mindyh/BitBot/Notes/bumper_top.png

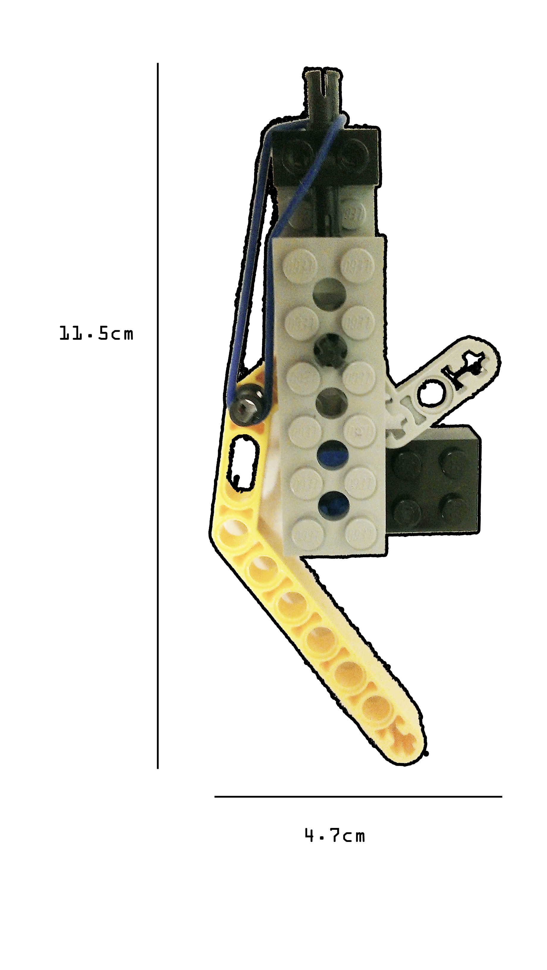
Notes/bumper_top.png
