mindyh/BitBot/README.md

BitBot
======

ME210 Project. Mindy Huang, Josh Grinberg, Pedro Milani, Chris Ling.
