mindyh/BitBot/Notes/bumper_side.png

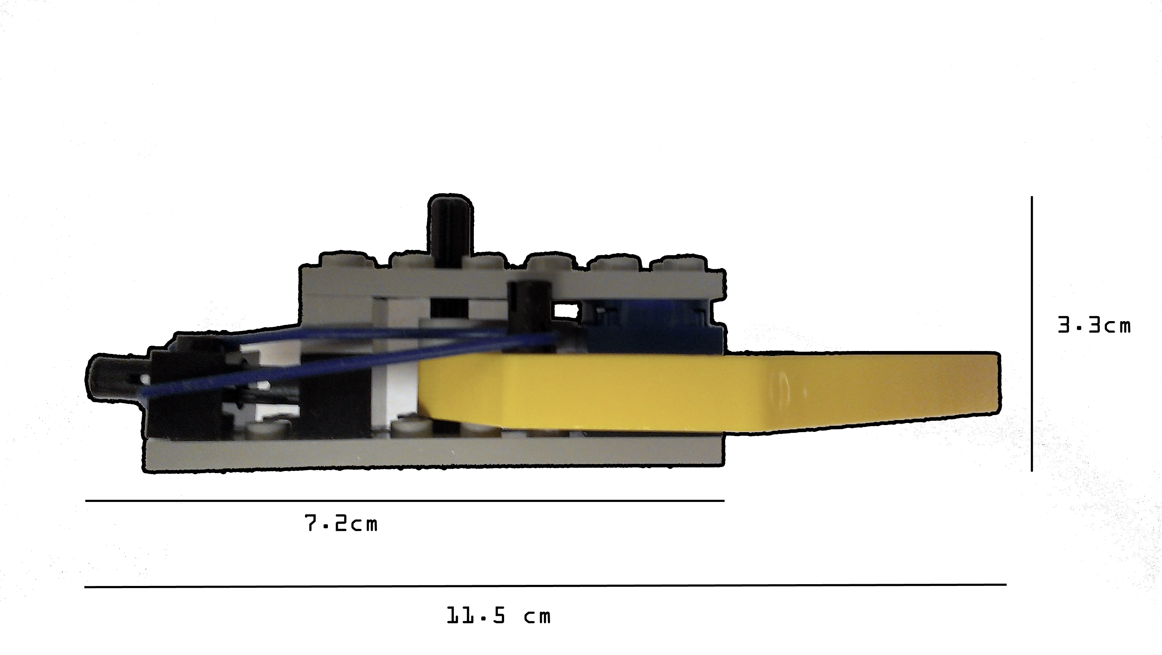
Notes/bumper_side.png
