mindyh/BitBot/Test/Beacon/beacon test results.txt

at no signal - ~511.
at 3k - b/t 470 and 530

160 - 770

w/o blinders, read signals up to 45 deg skewed
w/ my fingers as blinders, read signals up to ~10 deg skwed

need to do distance testing!!!
