mindyh/BitBot/BotCoin.ino

/*
* BotCoin.ino
* ---------------
* Mindy Huang
*/

#include <Timers.h>
#include "BotCoin.h"
#include <Drivetrain.h>
#include <Bumpers.h>
#include <Beacon.h>
#include <LineSensors.h>
#include <Turntable.h>
#include <ButtonPresser.h>
#include <Servo.h>

/*----- Module Variables ----*/
static Direction currentDirection;

Servo myservo;
Bumpers bumpers(BUMPER_FL_PIN, BUMPER_BL_PIN, BUMPER_FR_PIN, BUMPER_BR_PIN);
Beacon serverBeacon(BEACON_SERVER_PIN, BEACON_THRESHOLD_VAL);
Beacon exchangeBeacon(BEACON_EXCHANGE_PIN, BEACON_THRESHOLD_VAL);
Beacon sideServerBeacon(SIDE_SERVER_PIN, BEACON_THRESHOLD_VAL);
Beacon sideExchangeBeacon(SIDE_EXCHANGE_PIN, 250);
LineSensors lineSensors(LIGHT_PIN_CENTER, LIGHT_PIN_FRONT, LIGHT_THRESHOLD_VAL);
Drivetrain drivetrain(MOTOR_1_DIR_PIN, MOTOR_2_DIR_PIN, MOTOR_1_ENABLE_PIN, MOTOR_2_ENABLE_PIN);
Turntable turntable(TURNTABLE_ENABLE_PIN, TURNTABLE_DIR_PIN);
ButtonPresser presser(BUTTON_PRESSER_PIN, myservo);

Direction switchSpinDir = SPIN_LEFT;
static unsigned long time = 0;
static boolean isSeekingLine = false;
static SideOfServer startingSideOfServer;
static SideOfServer currSideOfServer;
static int numRuns = 0;
static TargetExchange targetExchange = targetOrder[numRuns];
static int targetPresses[] = {15, 45, 105};
static float targetCoins[] = {5.0, 3.0, 8.0};

    
/*---- Main Program ---*/
void setup()
{
    // initialize serial communication at 9600 bits per second:
    Serial.begin(9600);

    // init variables
    pinMode(HEARTBEAT_LED, OUTPUT);
    myservo.attach(BUTTON_PRESSER_PIN);
    digitalWrite(HEARTBEAT_LED, HIGH);
    serverBeacon.Clear();
    exchangeBeacon.Clear();
    sideExchangeBeacon.Clear();
    sideServerBeacon.Clear();
    drivetrain.Stop();
    presser.Press();

    // Start timers
    TMRArd_InitTimer(HEARTBEAT_TIMER, ONE_SEC / 2);   // to know we're alive
    TMRArd_InitTimer(CLEAR_BEACON_TIMER, BEACON_CLEAR_PERIOD); // we have 20Hz sampling rate on beacons
    // Bot to shut off automatically in 2 minutes
    TMRArd_InitTimer(ENDGAME_TIMER, 120 * ONE_SEC);  

    // clear timers to make sure they don't start expired
    TMRArd_ClearTimerExpired(BUTTON_PRESS_TIMER);
    TMRArd_ClearTimerExpired(BRAKING_TIMER);
    TMRArd_ClearTimerExpired(ALIGNING_TIMER);
    TMRArd_ClearTimerExpired(TRAVELLING_TIMER);
    TMRArd_ClearTimerExpired(SEEKING_TIMER);
}

void loop()
{
    static State currState = WAITING_TO_START;
    static State returnToState;
    static boolean isFirstRun = true;
    static int numCoinsMined = 0;
    static unsigned long startTime;
    static int numResetEndTimer = 0;
   // static int targetCoins;

    // Always do
    if (TMRArd_IsTimerExpired(HEARTBEAT_TIMER))
    {
        TMRArd_InitTimer(HEARTBEAT_TIMER, ONE_SEC);
        digitalWrite(HEARTBEAT_LED, !digitalRead(HEARTBEAT_LED));
    }

    exchangeBeacon.Update();
    serverBeacon.Update();
    sideExchangeBeacon.Update();
    sideServerBeacon.Update();

    if (TMRArd_IsTimerExpired(CLEAR_BEACON_TIMER))
    {
        serverBeacon.Clear();
        exchangeBeacon.Clear();
        sideServerBeacon.Clear();
        sideExchangeBeacon.Clear();
        TMRArd_InitTimer(CLEAR_BEACON_TIMER, BEACON_CLEAR_PERIOD);
    }
    
    if (TMRArd_IsTimerExpired(ENDGAME_TIMER))
    {
        if(numResetEndTimer == 3) {
          currState = WAITING_TO_END;
          turntable.Stop();
          drivetrain.Stop();
          presser.Rest();
        } else {
          TMRArd_InitTimer(ENDGAME_TIMER, (unsigned long)(30 * ONE_SEC));   
          numResetEndTimer++;
        }
    }

    // State dependent
    switch (currState)
    {
    case WAITING_TO_START:
        // kick to start
        if (bumpers.IsFrontPressed())
        {
            currState = SEEKING_SERVER;
            Transition(SEEKING_SERVER);
            // Bot to shut off automatically in 2 minutes
            TMRArd_InitTimer(ENDGAME_TIMER, (unsigned long)(30 * ONE_SEC));   
        }
        break;
    case SEEKING_SERVER:
        // found line, align with beacon
        if (lineSensors.IsCenterOverLine())
        {
            TMRArd_StopTimer(SEEKING_TIMER);
            TMRArd_ClearTimerExpired(SEEKING_TIMER);

            int deltaT = millis() - time;
            if (deltaT > DYNAMIC_BRAKE_TIME)
            {
                currState = BRAKING;
                returnToState = ALIGNING_WITH_SERVER;
                Brake(GetBrakeDir(), deltaT);
            }
            else
            {
                currState = ALIGNING_WITH_SERVER;
                Transition(ALIGNING_WITH_SERVER);
            }
        }
        // found the beacon, now spin left or right
        else if (serverBeacon.IsFacingBeacon()) 
        {
            // clear timer
            TMRArd_StopTimer(SEEKING_TIMER);
            TMRArd_ClearTimerExpired(SEEKING_TIMER);
            presser.Rest();

            // check what side of field you're on 
            if(isFirstRun) {
              isFirstRun = false;
              if(sideExchangeBeacon.IsFacingBeacon())  {
                  startingSideOfServer = RIGHT;
                  currSideOfServer = RIGHT;
                  presser.Press();
              }
              else {
                  startingSideOfServer = LEFT;
                  currSideOfServer = LEFT;
                  presser.Rest();
              }
            }

            // brake if necessary
            int deltaT = millis() - time;
            if (deltaT > DYNAMIC_BRAKE_TIME)
            {
                currState = BRAKING;
                returnToState = (currSideOfServer == LEFT) ? SEEKING_LEFT : SEEKING_RIGHT;
                Brake(GetBrakeDir(), deltaT);
            }
            else
            {
                currState = (currSideOfServer == LEFT) ? SEEKING_LEFT : SEEKING_RIGHT;
                Transition(currState);
            }

        } 
        // stuck in dead zone w/ no beacon signal. 
        // Go towards exchange (guaranteed to be found)
        else if (TMRArd_IsTimerExpired(SEEKING_TIMER))
        {
            TMRArd_ClearTimerExpired(SEEKING_TIMER);

            currState = SEEKING_EXCHANGE_2;
            Transition(SEEKING_EXCHANGE_2);
        }
        break;

    case SEEKING_RIGHT:
        if(TMRArd_IsTimerExpired(SEEKING_TIMER)) {
            TMRArd_ClearTimerExpired(SEEKING_TIMER);
            currState = TRAVELLING_TO_SERVER;
            Transition(TRAVELLING_TO_SERVER);
        }
        break;

    case SEEKING_LEFT:
        if(TMRArd_IsTimerExpired(SEEKING_TIMER)) {
            TMRArd_ClearTimerExpired(SEEKING_TIMER);
            currState = TRAVELLING_TO_SERVER;
            Transition(TRAVELLING_TO_SERVER);
        }
        break;

    case SEEKING_EXCHANGE_2:
        // found exchange, go towards it and resume searching for server
        if(exchangeBeacon.IsFacingBeacon()) 
        {
            TMRArd_StopTimer(SEEKING_TIMER);
            TMRArd_ClearTimerExpired(SEEKING_TIMER);

            currState = BACKING_UP;
            returnToState = SEEKING_SERVER;
            Backup(1.5, BACKWARD);
        }
        // did not find (should never happen), randomly 
        // drive somewhere and try again
        else if (TMRArd_IsTimerExpired(SEEKING_TIMER)) {
            TMRArd_ClearTimerExpired(SEEKING_TIMER);

            currState = TRAVELLING_TO_SERVER;
            Transition(TRAVELLING_TO_SERVER);
        }
        break;

    case TRAVELLING_TO_SERVER:
        // Found line, align with server
        if (lineSensors.IsCenterOverLine())
        {
            TMRArd_StopTimer(TRAVELLING_TIMER);
            TMRArd_ClearTimerExpired(TRAVELLING_TIMER);
            
            int deltaT = millis() - time + 100;
            if (deltaT > DYNAMIC_BRAKE_TIME)
            {
                currState = BRAKING;
                returnToState = ALIGNING_WITH_SERVER;
                Brake(GetBrakeDir(), deltaT);
            }
            else
            {
                currState = ALIGNING_WITH_SERVER;
                Transition(ALIGNING_WITH_SERVER);
            }
        }
        // hit a wall, back up and try again
        else if (bumpers.IsFrontPressed())
        {
            TMRArd_StopTimer(TRAVELLING_TIMER);
            TMRArd_ClearTimerExpired(TRAVELLING_TIMER);
            
            currState = BACKING_UP;
            returnToState = SEEKING_SERVER;
            Backup(1, BACKWARD);
        }

        // went a long time without seeing anything. Try again.
        else if (TMRArd_IsTimerExpired(TRAVELLING_TIMER) && !serverBeacon.IsFacingBeacon())
        {
            TMRArd_ClearTimerExpired(TRAVELLING_TIMER);
            currState = SEEKING_SERVER;
            currSideOfServer = (currSideOfServer == LEFT) ? RIGHT : LEFT;
            Transition(SEEKING_SERVER);
        }
        break;

    case ALIGNING_WITH_SERVER:
        // found beacon, go to it
        if (serverBeacon.IsFacingBeacon())
        {
            int deltaT = millis() - time;
            if (deltaT > DYNAMIC_BRAKE_TIME)
            {
                currState = BRAKING;
                returnToState = GOING_TO_SERVER_WALL;

                Brake(GetBrakeDir(), deltaT);
            }
            else
            {
                currState = GOING_TO_SERVER_WALL;
                Transition(GOING_TO_SERVER_WALL);
            }
        }
        // hit a wall, assume trouble rotating.
        // Back up and try again
        else if (bumpers.IsFrontPressed() || bumpers.IsBackPressed())
        {
            currState = BACKING_UP;
            returnToState = TRAVELLING_TO_SERVER;
            Backup(1, BACKWARD);
            isSeekingLine = true;
        }
        break;

    case GOING_TO_SERVER_WALL:
        // at the wall, align with it now
        if (bumpers.IsFrontPressed())
        {
            drivetrain.GoForward(DRIVE_RATE);
            currState = ALIGNING_WITH_SERVER_WALL;
            TMRArd_InitTimer(ALIGNING_TIMER, ALIGNING_TIME);
        }
        // went off track, try to find it again
        else if (!serverBeacon.IsFacingBeacon())
        {
            currState = ALIGNING_WITH_SERVER;
            Transition(ALIGNING_WITH_SERVER);
        }
        break;

    case ALIGNING_WITH_SERVER_WALL:
        // assume you're perfectly positioned and mine coins.
        if (TMRArd_IsTimerExpired(ALIGNING_TIMER))
        {
            TMRArd_ClearTimerExpired(ALIGNING_TIMER);
            currState = BUTTON_PRESSING;
            TMRArd_InitTimer(BUTTON_PRESS_TIMER, BUTTON_PRESS_INTERVAL);
            drivetrain.Stop();
        }
        break;

    case BUTTON_PRESSING:
        //int targetPresses = (targetCoins + 1)*targetCoins/2;
        static int numPresses = 0;
        // mined target number of coins. Go find an exchange.
        if (numPresses == targetPresses[numRuns] + 2)
        {
            presser.Rest();

            currState = BACKING_UP;
            if(targetExchange == EIGHT)
                returnToState = SEEKING_EXCHANGE;
            else
                returnToState = ALIGNING_SIDE_WITH_SERVER;

            Backup(1, BACKWARD);
        }
        else
        {
            PressButton(&numPresses);
        }

        // if 15 seconds left on the timer, dump everything in 8
        if((millis() - startTime) > (unsigned int)(105*ONE_SEC)) {
            currState = BACKING_UP;
            returnToState = SEEKING_EXCHANGE;
            Backup(2, BACKWARD);
        }
        break;

   case ALIGNING_SIDE_WITH_SERVER:
       if(sideServerBeacon.IsFacingBeacon()) {
           int deltaT = millis() - time;
           if (deltaT > DYNAMIC_BRAKE_TIME)
           {
               currState = BRAKING;
               returnToState = ALIGNING_SIDE_WITH_EXCHANGE;
               Brake(GetBrakeDir(), deltaT);
           }
           else
           {
               currState = ALIGNING_SIDE_WITH_EXCHANGE;
               Transition(ALIGNING_SIDE_WITH_EXCHANGE);
           }
       }
       break;

    case ALIGNING_SIDE_WITH_EXCHANGE:
       if(TMRArd_IsTimerExpired(TRAVELLING_TIMER) && sideExchangeBeacon.IsFacingBeacon()) {
            TMRArd_ClearTimerExpired(TRAVELLING_TIMER);
            
           int deltaT = millis() - time;
           if (deltaT > DYNAMIC_BRAKE_TIME)
           {
                currState = BRAKING;
                returnToState = SEEKING_EXCHANGE;
                Brake(GetBrakeDir(), deltaT);
           }
           else
           {
               currState = SEEKING_EXCHANGE;
               Transition(SEEKING_EXCHANGE);
           }
            // 5 beacon was taken, go for 3
        } else if ((targetExchange == FIVE) && 
                    (bumpers.IsFrontPressed() || bumpers.IsBackPressed())) {
           
            numRuns++;
            targetExchange = targetOrder[numRuns];
            currState = ALIGNING_WITH_WALL;
            TMRArd_InitTimer(ALIGNING_TIMER, ONE_SEC);

            // 3 beacon was taken, go for 8
        } else if ((targetExchange == THREE) && 
                    (bumpers.IsFrontPressed() || bumpers.IsBackPressed())) {

            if(drivetrain.GetLastDir() == FORWARD) {
                drivetrain.GoBackward(DRIVE_RATE);
            } else {
                drivetrain.GoForward(DRIVE_RATE);
            }
            numRuns++;
            targetExchange = targetOrder[numRuns];
        } 
        break;

    case ALIGNING_WITH_WALL:
        if(TMRArd_IsTimerExpired(ALIGNING_TIMER)) {
            if(drivetrain.GetLastDir() == FORWARD) {
                drivetrain.GoBackward(DRIVE_RATE);
            } else {
                drivetrain.GoForward(DRIVE_RATE);
            }

            currState = CROSSING_FIELD;
        }
        break;

    case CROSSING_FIELD:
        if(sideServerBeacon.IsFacingBeacon()) {
            currSideOfServer = (currSideOfServer == LEFT) ? RIGHT : LEFT;
            currState = ALIGNING_SIDE_WITH_EXCHANGE;
            TMRArd_InitTimer(TRAVELLING_TIMER, 1.5*ONE_SEC);
        } 
        // else if (bumpers.IsFrontPressed()) {
        //     // hit a wall, back up and 
        //     curr
        // }
        break;

    case SEEKING_EXCHANGE:
        presser.Press();
        // found exchange, go towards it
        if (exchangeBeacon.IsFacingBeacon())
        {
            int deltaT = millis() - time;
            if (deltaT > DYNAMIC_BRAKE_TIME)  // if it's spinning already
            {
                currState = BRAKING;
                returnToState = TRAVELLING_TO_EXCHANGE;
                
                Brake(GetBrakeDir(), deltaT);
            }
            else // if it started facing the server
            {
                currState = TRAVELLING_TO_EXCHANGE;
                Transition(TRAVELLING_TO_EXCHANGE);
            }
            TMRArd_StopTimer(SEEKING_TIME);
            TMRArd_ClearTimerExpired(SEEKING_TIMER);
            TMRArd_InitTimer(SEEKING_TIMER, ONE_SEC/4);
        }
        // cannot find any exchanges. Align with the server
        // and try agin
        else if (TMRArd_IsTimerExpired(SEEKING_TIMER))
        {
            TMRArd_ClearTimerExpired(SEEKING_TIMER);
            currState = SEEKING_SERVER_2;
            Transition(SEEKING_SERVER_2);
        }
        break;

    case SEEKING_SERVER_2:
        // found exchange, go towards it and resume searching for server
        if(serverBeacon.IsFacingBeacon()) 
        {
            TMRArd_StopTimer(SEEKING_TIMER);
            TMRArd_ClearTimerExpired(SEEKING_TIMER);

            currState = BACKING_UP;
            returnToState = SEEKING_EXCHANGE;
            Backup(1.5, FORWARD);
        }
        // did not find (should never happen), randomly 
        // drive somewhere and try again
        else if (TMRArd_IsTimerExpired(SEEKING_TIMER)) {
            TMRArd_ClearTimerExpired(SEEKING_TIMER);

            currState = TRAVELLING_TO_EXCHANGE;
            Transition(TRAVELLING_TO_EXCHANGE);
        }
        break;

    case TRAVELLING_TO_EXCHANGE:
        presser.Rest();
        // lost track of the exchange. Find another one.
        if (!exchangeBeacon.IsFacingBeacon() && TMRArd_IsTimerExpired(SEEKING_TIMER))
        {
            TMRArd_StopTimer(TRAVELLING_TIMER);
            TMRArd_ClearTimerExpired(TRAVELLING_TIMER);
            TMRArd_ClearTimerExpired(SEEKING_TIMER);

            currState = SEEKING_EXCHANGE;
            Transition(SEEKING_EXCHANGE);
        }
        // at the exchange. Align with it before dropping coins.
        else if (bumpers.IsBackPressed() || TMRArd_IsTimerExpired(TRAVELLING_TIMER))
        {
            TMRArd_ClearTimerExpired(TRAVELLING_TIMER);

            drivetrain.GoBackward(DRIVE_RATE);
            TMRArd_InitTimer(ALIGNING_TIMER, ALIGNING_TIME);
            currState = ALIGNING_WITH_EXCHANGE_WALL;
        }
        break;

    case ALIGNING_WITH_EXCHANGE_WALL:
        // assume you're perfectly aligned. Start dispensing.
        if (TMRArd_IsTimerExpired(ALIGNING_TIMER))
        {
            drivetrain.Stop();
            TMRArd_ClearTimerExpired(ALIGNING_TIMER);

            currState = DISPENSING;
            turntable.TurnCW(TURNTABLE_RATE);
            TMRArd_InitTimer(DISPENSER_TIMER, DISPENSING_TIME);
        }
        break;

    case DISPENSING:
        static int numTurns = 0;
        if (TMRArd_IsTimerExpired(DISPENSER_TIMER))
        {
            //  After you're done dispensing, back up and 
            // mine more coins
            if (numTurns == 1)
            {
                numTurns = 0;
                turntable.Stop();
                TMRArd_ClearTimerExpired(DISPENSER_TIMER);

                currState = BACKING_UP;
                returnToState = SEEKING_SERVER;
                Backup(1, FORWARD);

                // update current side of server
                if((startingSideOfServer == LEFT && targetExchange == FIVE) ||
                    startingSideOfServer == RIGHT && targetExchange == THREE)
                    currSideOfServer = LEFT;
                else 
                    currSideOfServer = RIGHT;

                // update target exchange
                if(numRuns < 2) numRuns++;
                targetExchange = targetOrder[numRuns];
            }
            // switch direction of dispenser every so often,
            // just in case.
            else
            {
                if (turntable.GetLastDir() == CCW)
                    turntable.TurnCW(TURNTABLE_RATE);
                else
                    turntable.TurnCCW(TURNTABLE_RATE);

                TMRArd_InitTimer(DISPENSER_TIMER, DISPENSING_TIME/2);
                numTurns++;
            }
        }
        break;
    case WAITING_TO_END:
        // do nothing
        break;

    // special state, returns to whatever state was 
    // set in returnToState
    case BRAKING:
        if (TMRArd_IsTimerExpired(BRAKING_TIMER))
        {
            TMRArd_ClearTimerExpired(BRAKING_TIMER);
            drivetrain.Stop();
            currState = returnToState;
            Transition(returnToState);
        }
        break;

    case BACKING_UP:
        // only stop backing up if we're looking for the line 
        // and found it
        if (isSeekingLine && lineSensors.IsCenterOverLine())
        {
            int deltaT = millis() - time;
            if (deltaT > DYNAMIC_BRAKE_TIME)
            {
                currState = BRAKING;
                returnToState = ALIGNING_WITH_SERVER;
                Brake(GetBrakeDir(), deltaT);
            }
            else
            {
                currState = ALIGNING_WITH_SERVER;
                Transition(ALIGNING_WITH_SERVER);
            }
        }
        else if (TMRArd_IsTimerExpired(BACKING_UP_TIMER))
        {
            TMRArd_ClearTimerExpired(BACKING_UP_TIMER);

            currState = returnToState;
            Transition(returnToState);
        }
        break;

    default: break;
    }
}

/*--------Module Functions -------------*/
Direction GetBrakeDir() {
    if(drivetrain.GetLastDir() == SPIN_LEFT) 
        return SPIN_RIGHT;
    else if(drivetrain.GetLastDir() == SPIN_RIGHT)
        return SPIN_LEFT;
    else if(drivetrain.GetLastDir() == FORWARD)
        return BACKWARD;
    else
        return FORWARD;
}


Direction CalculateDir() {
    if(startingSideOfServer == LEFT && targetExchange == FIVE) {
        return FORWARD;
    } else if (startingSideOfServer == LEFT && targetExchange == THREE) {
        return BACKWARD;
    } else if (startingSideOfServer == RIGHT && targetExchange == FIVE) {
        return BACKWARD;
    } else {
        return FORWARD;
    }
}

/* ALWAYS set currState = BACKING_UP and returnToState before calling */
void Backup(float duration, Direction dir)
{
    time = millis();
    TMRArd_InitTimer(BACKING_UP_TIMER, ONE_SEC * duration);
    if (dir == BACKWARD)
        drivetrain.GoBackward(DRIVE_RATE);
    else
        drivetrain.GoForward(DRIVE_RATE);
}

/* ALWAYS set currState = BRAKING and returnToState before calling */
void Brake(Direction dirToBrake, int deltaT)
{
    if(deltaT > FAST_BRAKE_TIME)
        TMRArd_InitTimer(BRAKING_TIMER, BRAKING_INTERVAL*2);
    else 
        TMRArd_InitTimer(BRAKING_TIMER, BRAKING_INTERVAL);

    switch (dirToBrake)
    {
    case FORWARD:
        drivetrain.GoForward(DRIVE_RATE);
        break;
    case BACKWARD:
        drivetrain.GoBackward(DRIVE_RATE);
        break;
    case SPIN_LEFT:
        drivetrain.SpinLeft(SPIN_RATE);
        break;
    case SPIN_RIGHT:
        drivetrain.SpinRight(SPIN_RATE);
        break;
    case SPIN:
        if (switchSpinDir == SPIN_LEFT)
            drivetrain.SpinLeft(SPIN_RATE);
        else
            drivetrain.SpinRight(SPIN_RATE);
        break;
    default: break;
    }
}

// Transitions to each state.
// Does not include Braking and Backing up.
void Transition(State state)
{
    switch (state)
    {
    case SEEKING_SERVER:
        TMRArd_InitTimer(SEEKING_TIMER, SEEKING_TIME);
        SwitchSpin();
        time = millis();
        isSeekingLine = true;
        break;

    case SEEKING_RIGHT:
        TMRArd_InitTimer(SEEKING_TIMER, ONE_SEC/3);
        drivetrain.SpinRight(SPIN_RATE);
        break;

    case SEEKING_LEFT:
        TMRArd_InitTimer(SEEKING_TIMER, ONE_SEC/3);
        drivetrain.SpinLeft(SPIN_RATE);
        break;

    case SEEKING_EXCHANGE_2:
        TMRArd_InitTimer(SEEKING_TIMER, SEEKING_TIME);
        SwitchSpin();
        time = millis();
        isSeekingLine = true;
        break;

    case TRAVELLING_TO_SERVER:
        presser.Rest();
        drivetrain.GoForward(DRIVE_RATE);
        TMRArd_InitTimer(TRAVELLING_TIMER, TRAVELLING_TIME + 200);
        time = millis();
        isSeekingLine = true;
        break;

    case ALIGNING_WITH_SERVER:
        SwitchSpin();
        time = millis();
        isSeekingLine = false;
        break;

    case GOING_TO_SERVER_WALL:
        drivetrain.GoForward(DRIVE_RATE);
        break;

    case ALIGNING_SIDE_WITH_SERVER:
        drivetrain.SpinRight(SPIN_RATE);
        time = millis();
        break;

    case ALIGNING_SIDE_WITH_EXCHANGE:
        TMRArd_InitTimer(TRAVELLING_TIMER, 2*ONE_SEC);
        if(CalculateDir() == FORWARD) {
            drivetrain.GoForward(DRIVE_RATE);
        } else {
            drivetrain.GoBackward(DRIVE_RATE);
        }
        time = millis();
        break;

    case SEEKING_EXCHANGE:
        TMRArd_InitTimer(SEEKING_TIMER, SEEKING_TIME);
        time = millis();
        if(startingSideOfServer == LEFT && targetExchange == FIVE) 
            drivetrain.SpinRight(SPIN_RATE);
        else if(startingSideOfServer == LEFT && targetExchange == THREE) 
            drivetrain.SpinLeft(SPIN_RATE);
        else if(startingSideOfServer == RIGHT && targetExchange == FIVE) 
            drivetrain.SpinLeft(SPIN_RATE);
        else if(startingSideOfServer == RIGHT && targetExchange == THREE) 
            drivetrain.SpinRight(SPIN_RATE);

        presser.Press();
        break;

    case TRAVELLING_TO_EXCHANGE:
        presser.Rest();
        drivetrain.GoBackward(DRIVE_RATE);
        TMRArd_InitTimer(TRAVELLING_TIMER, TRAVELLING_TIME*2);
        break;

    case SEEKING_SERVER_2:
        SwitchSpin();
        time = millis();
        TMRArd_InitTimer(SEEKING_TIMER, SEEKING_TIME);
        break;

    default: break;
    }
}

void PressButton(int *numPresses)
{
    if (TMRArd_IsTimerExpired(BUTTON_PRESS_TIMER))
    {
        if (presser.GetPosition() == PRESS)
            presser.Withdraw();
        else
        {
            presser.Press();
            (*numPresses)++;
        }

        TMRArd_InitTimer(BUTTON_PRESS_TIMER, BUTTON_PRESS_INTERVAL);
    }
}

void SwitchSpin()
{
    if (switchSpinDir == SPIN_LEFT)
    {
        drivetrain.SpinLeft(SPIN_RATE);
        switchSpinDir = SPIN_RIGHT;
    }
    else
    {
        drivetrain.SpinRight(SPIN_RATE);
        switchSpinDir = SPIN_LEFT;
    }
}
