mindyh/BitBot/BotCoin.h

/* BotCoin.h
 * ------------
 * Mindy Huang (mindyh@stanford.edu)
 */

/*---------------- Defines ---------------------------*/
#ifndef BOTCOIN_H
#define BOTCOIN_H

#include "Arduino.h"

// Digital Pins
#define TURNTABLE_DIR_PIN       2
#define TURNTABLE_ENABLE_PIN    3  
#define MOTOR_2_DIR_PIN         4
#define MOTOR_2_ENABLE_PIN      5
#define MOTOR_1_ENABLE_PIN      6
#define MOTOR_1_DIR_PIN         7
#define BUTTON_PRESSER_PIN      8
#define BUMPER_BR_PIN           9
#define BUMPER_BL_PIN           10
#define BUMPER_FL_PIN           12
#define BUMPER_FR_PIN           12
#define TURNTABLE_CLICKER_PIN   11
#define HEARTBEAT_LED           13

// Analog Pins
#define LIGHT_PIN_FRONT         A0
#define LIGHT_PIN_CENTER        A1
#define BEACON_SERVER_PIN       A2
#define BEACON_EXCHANGE_PIN     A3
#define SIDE_EXCHANGE_PIN       A4
#define SIDE_SERVER_PIN         A5

// Timers
#define HEARTBEAT_TIMER         1
#define ENDGAME_TIMER           2
#define CLEAR_BEACON_TIMER      3
#define DISPENSER_TIMER         4
#define BUTTON_PRESS_TIMER      5
#define BRAKING_TIMER           6
#define TRAVELLING_TIMER        7
#define LINE_TRACKING_TIMER     8
#define ALIGNING_TIMER          9
#define SEEKING_TIMER           10
#define BACKING_UP_TIMER        11

// Values
#define ONE_SEC               1000
#define BEACON_CLEAR_PERIOD   ONE_SEC/20
#define BUTTON_PRESS_INTERVAL ONE_SEC/3.5
#define BEACON_THRESHOLD_VAL  400
#define LIGHT_THRESHOLD_VAL   200 
#define BRAKING_INTERVAL      ONE_SEC/4
#define TRAVELLING_TIME       2.5*ONE_SEC 
#define SPIN_RATE             150
#define SLOW_SPIN_RATE        130   
#define SLOW_DRIVE_RATE       150
#define DRIVE_RATE            180
#define TURNTABLE_RATE        250
#define LINE_TRACKING_TIME    2*ONE_SEC
#define ALIGNING_TIME         ONE_SEC*2
#define DYNAMIC_BRAKE_TIME    ONE_SEC/2
#define FAST_BRAKE_TIME       ONE_SEC
#define SEEKING_TIME          4*ONE_SEC
#define DISPENSING_TIME       4*ONE_SEC

// states
enum State {
    WAITING_TO_START,
    SEEKING_SERVER,
    SEEKING_EXCHANGE_2,
    SEEKING_RIGHT,
    SEEKING_LEFT,
    TRAVELLING_TO_SERVER,
    ALIGNING_WITH_SERVER,
    ALIGNING_WITH_SERVER_WALL,
    GOING_TO_SERVER_WALL,
    BUTTON_PRESSING,
    ALIGNING_SIDE_WITH_SERVER,
    ALIGNING_SIDE_WITH_EXCHANGE,
    ALIGNING_WITH_WALL,
    CROSSING_FIELD,
    SEEKING_EXCHANGE,
    SEEKING_SERVER_2,
    TRAVELLING_TO_EXCHANGE,
    ALIGNING_WITH_EXCHANGE_WALL,
    DISPENSING,
    WAITING_TO_END,
    BACKING_UP,
    BRAKING
};

enum Bumper {
    FL,
    FR,
    BL,
    BR
};

enum SideOfServer {
    LEFT,
    RIGHT
};

enum TargetExchange {
    THREE,
    FIVE,
    EIGHT
};

TargetExchange targetOrder[] = {FIVE, THREE, EIGHT};
  

#endif
