mindyh/BitBot/(commit log)

2014-03-05 removed dynamic braking when the bot isn't turning already. added reversing directions for turntable
    [BotCoin.h, BotCoin.ino]
2014-03-07 added logic to repeat game, align yourself with another exchange if you're stuck in a dead zone (instead of crashing into walls), and commented everything
    [BotCoin.ino]
2014-03-07 deleted unused code and fixed syntax errors
    [BotCoin.h, BotCoin.ino]
2014-03-10 fixed wheels veering off course
    [BotCoin.h, BotCoin.ino]
